MikePythons/RP2040smol/PCB/RP2040smol.kicad_pcb

## KiCad design PCB/RP2040smol.kicad_pcb (2022-01-14)

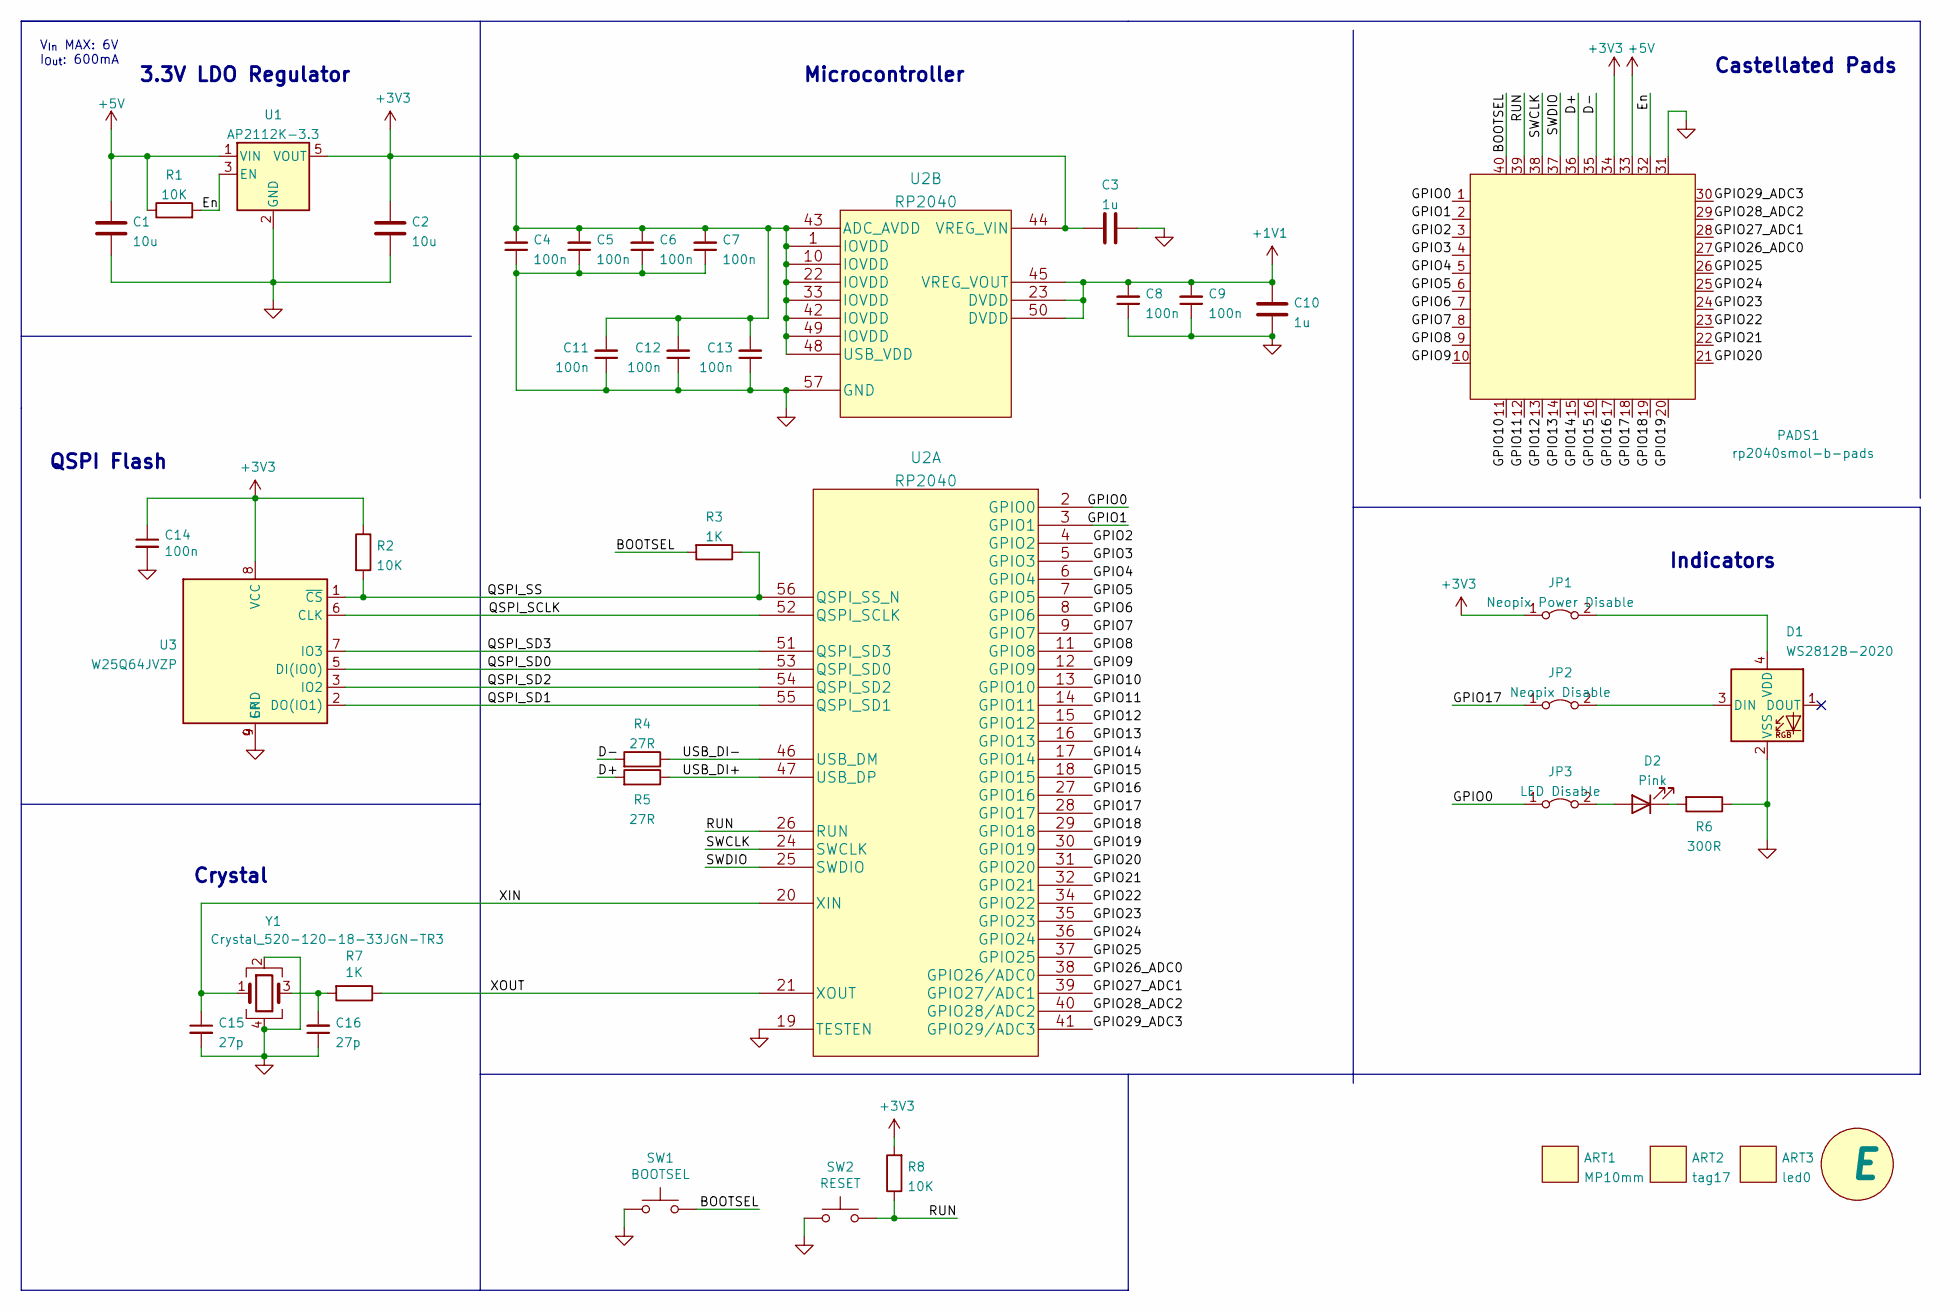
[picture p1: schematic RP2040smol.kicad_sch, RP2040_{smol}]

Parts:
ART1: MP10mm; MPSquare_10mm
ART2: tag17
ART3: led0; badge0
C1, C2: 10u; C_0603_1608Metric
C3, C10: 1u; C_0603_1608Metric
C4, C5, C6, C7, C8, C9, C11, C12, C13, C14: 100n; C_0603_1608Metric
C15, C16: 27p; C_0603_1608Metric
D1: WS2812B-2020; WS2812b-2020
D2: Pink; LED_0603_1608Metric
JP1: Neopix Power Disable; Covered_SolderJumper-2_P1.3mm_Bridged_RoundedPad1.0x1.5mm
JP2: Neopix Disable; Covered_SolderJumper-2_P1.3mm_Bridged_RoundedPad1.0x1.5mm
JP3: LED Disable; Covered_SolderJumper-2_P1.3mm_Bridged_RoundedPad1.0x1.5mm
MISC1: E; RevisionSymbol_Small
PADS1: rp2040smol-b-pads; Castellated_4x10_smol_dual
R1, R2, R8: 10K; R_0603_1608Metric
R3, R7: 1K; R_0603_1608Metric
R4, R5: 27R; R_0603_1608Metric
R6: 300R; R_0603_1608Metric
SW1: BOOTSEL; SW_Push_SPST_Alps_SKRK_Clone
SW2: RESET; SW_Push_SPST_Alps_SKRK_Clone
U1: AP2112K-3.3; SOT-23-5
U2: RP2040
U3: W25Q64JVZP; WSON-8-1EP_6x5mm_P1.27mm_EP3.4x4.3mm
Y1: Crystal_520-120-18-33JGN-TR3; Crystal_SMD_Abracon_ABM8G-4Pin_3.2x2.5mm

Connections:
+1V1: C8.2, C9.2, C10.2, U2.23 (DVDD), U2.45 (VREG_VOUT), U2.50 (DVDD)
+3V3: C2.1, C3.2, C4.2, C5.2, C6.2, C7.2, C11.2, C12.2, C13.2, C14.1, JP1.1 (A), PADS1.34, R2.1, R8.2, U1.5 (VOUT), U2.1 (IOVDD), U2.10 (IOVDD), U2.22 (IOVDD), U2.33 (IOVDD), U2.42 (IOVDD), U2.43 (ADC_AVDD), U2.44 (VREG_VIN), U2.48 (USB_VDD), U2.49 (IOVDD), U3.8 (VCC)
+5V: C1.1, PADS1.33, R1.1, U1.1 (VIN)
/BOOTSEL: PADS1.40, R3.2, SW1.2
/D+: PADS1.36, R5.2
/D-: PADS1.35, R4.2
/En: PADS1.32, R1.2, U1.3 (EN)
/GPIO0: JP3.1 (A), PADS1.1, U2.2 (GPIO0)
/GPIO1: PADS1.2, U2.3 (GPIO1)
/GPIO2: PADS1.3, U2.4 (GPIO2)
/GPIO3: PADS1.4, U2.5 (GPIO3)
/GPIO4: PADS1.5, U2.6 (GPIO4)
/GPIO5: PADS1.6, U2.7 (GPIO5)
/GPIO6: PADS1.7, U2.8 (GPIO6)
/GPIO7: PADS1.8, U2.9 (GPIO7)
/GPIO8: PADS1.9, U2.11 (GPIO8)
/GPIO9: PADS1.10, U2.12 (GPIO9)
/GPIO10: PADS1.11, U2.13 (GPIO10)
/GPIO11: PADS1.12, U2.14 (GPIO11)
/GPIO12: PADS1.13, U2.15 (GPIO12)
/GPIO13: PADS1.14, U2.16 (GPIO13)
/GPIO14: PADS1.15, U2.17 (GPIO14)
/GPIO15: PADS1.16, U2.18 (GPIO15)
/GPIO16: PADS1.17, U2.27 (GPIO16)
/GPIO17: JP2.1 (A), PADS1.18, U2.28 (GPIO17)
/GPIO18: PADS1.19, U2.29 (GPIO18)
/GPIO19: PADS1.20, U2.30 (GPIO19)
/GPIO20: PADS1.21, U2.31 (GPIO20)
/GPIO21: PADS1.22, U2.32 (GPIO21)
/GPIO22: PADS1.23, U2.34 (GPIO22)
/GPIO23: PADS1.24, U2.35 (GPIO23)
/GPIO24: PADS1.25, U2.36 (GPIO24)
/GPIO25: PADS1.26, U2.37 (GPIO25)
/GPIO26_ADC0: PADS1.27, U2.38 (GPIO26/ADC0)
/GPIO27_ADC1: PADS1.28, U2.39 (GPIO27/ADC1)
/GPIO28_ADC2: PADS1.29, U2.40 (GPIO28/ADC2)
/GPIO29_ADC3: PADS1.30, U2.41 (GPIO29/ADC3)
/QSPI_SCLK: U2.52 (QSPI_SCLK), U3.6 (CLK)
/QSPI_SD0: U2.53 (QSPI_SD0), U3.5 (DI(IO0))
/QSPI_SD1: U2.55 (QSPI_SD1), U3.2 (DO(IO1))
/QSPI_SD2: U2.54 (QSPI_SD2), U3.3 (IO2)
/QSPI_SD3: U2.51 (QSPI_SD3), U3.7 (IO3)
/QSPI_SS: R2.2, R3.1, U2.56 (QSPI_SS_N), U3.1 (~CS)
/RUN: PADS1.39, R8.1, SW2.2, U2.26 (RUN)
/SWCLK: PADS1.38, U2.24 (SWCLK)
/SWDIO: PADS1.37, U2.25 (SWDIO)
/USB_DI+: R5.1, U2.47 (USB_DP)
/USB_DI-: R4.1, U2.46 (USB_DM)
/XIN: C15.1, U2.20 (XIN), Y1.1
/XOUT: R7.1, U2.21 (XOUT)
GND: C1.2, C2.2, C3.1, C4.1, C5.1, C6.1, C7.1, C8.1, C9.1, C10.1, C11.1, C12.1, C13.1, C14.2, C15.2, C16.1, D1.2 (VSS), PADS1.31, R6.1, SW1.1, SW2.1, U1.2 (GND), U2.19 (TESTEN), U2.57 (GND), U3.4 (GND), U3.9 (EP), Y1.2, Y1.4
unnamed: C16.2, R7.2, Y1.3
unnamed: D1.3 (DIN), JP2.2 (B)
unnamed: D1.4 (VDD), JP1.2 (B)
unnamed: D2.1 (K), R6.2
unnamed: D2.2 (A), JP3.2 (B)

Notes on the sheet:
Castellated Pads
QSPI Flash
Crystal
Microcontroller
3.3V LDO Regulator
V_{In} MAX: 6V I_{Out}: 600mA
Indicators

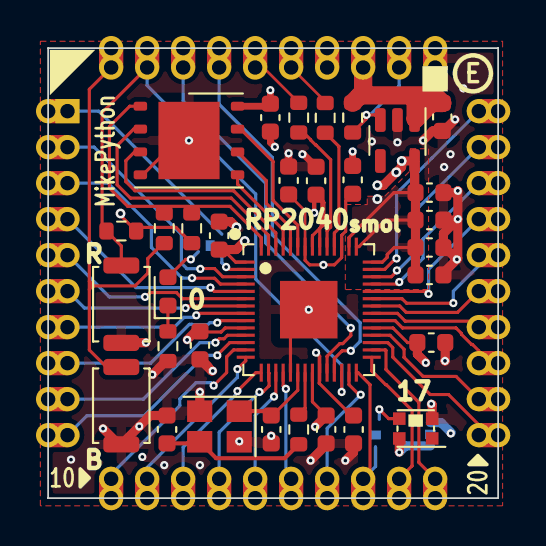
[picture p2: board RP2040smol.kicad_pcb from above]

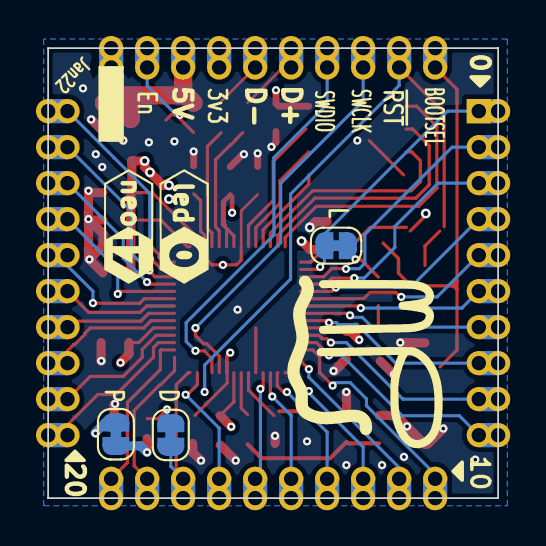
[picture p3: board RP2040smol.kicad_pcb from below]

Board: 4 copper layers, 25.0 x 25.0 mm, 40 parts (6 on the bottom side), 56 nets.
