MikePythons/RP2040smol/(commit log)

2021-12-17 Design files
    [MiniMike_RP2040-B_Cu.gbr, MiniMike_RP2040-B_Mask.gbr, MiniMike_RP2040-B_Silkscreen.gbr, MiniMike_RP2040-Edge_Cuts.gbr, MiniMike_RP2040-F_Cu.gbr, MiniMike_RP2040-F_Mask.gbr, MiniMike_RP2040-F_Paste.gbr, MiniMike_RP2040-F_Silkscreen.gbr]
2021-12-22 RevD.
    * All small passives are now 0603+
    * Pads for RP2040 and MIC5528 have been extended to try to make soldering more reasonable
    * Removed WS2812b capacitor. Hopefully the board has enough capacitance without it.
    * Rearranged BOOTSEL and Reset buttons
    [MiniMike_RP2040-B_Cu.gbr, MiniMike_RP2040-B_Mask.gbr, MiniMike_RP2040-B_Silkscreen.gbr, MiniMike_RP2040-Edge_Cuts.gbr, MiniMike_RP2040-F_Cu.gbr, MiniMike_RP2040-F_Mask.gbr, MiniMike_RP2040-F_Paste.gbr, MiniMike_RP2040-F_Silkscreen.gbr]
2022-01-07 HTML BoM fix - no physical board changes. * Set solder jumpers and castellated pads on schematic to "Exclude from BOM" * Generated RevD BoM HTML
    [RP2040smol.kicad_pcb, RP2040smol.kicad_sch]
2022-01-07 * Major schematic tidy * Changed LDO to SOT23-5 AP2112K-3.3
    [RP2040smol.kicad_pcb, RP2040smol.kicad_sch]
2022-01-08 Squeezed the bigger LDO onto the board...
    [RP2040smol.kicad_pcb, RP2040smol.kicad_sch]
2022-01-14 Tidied front silks
    [RP2040smol.kicad_pcb]
2022-01-14 3v3 vias
    [RP2040smol.kicad_pcb]
